HarrydeBug/WSPR-Receivers/Version4/README.md

# 1010-WSPR-RX_V2
Arduino firmware for WSPR-RX Hardware Version 4 with ESP82885 MCU
Harware version 4 is a Upper Sideband - Single Sideband recevier, the previous version were Double Sideband receivers.

LO Frequency and Crystal frequency is set with Serial commands and stored in EEPROM
The output frequency from the Si5351 is four times the LO frequency.
