HarrydeBug/WSPR-Receivers/Version4/Documentation/Ver4-rev 3 and 4 Audio Cable problem.pdf

### Important note on cable insertion on WSPR-RX Hardware Version 4.3 and 4.4

In version 4.3 and 4.4 of the WSPR receivers the audio out female does not protrude long enough to give a good connection unless the audio cable is pushed all the way in.
If the cable is not pushed all the way so the side of the audio cable is flush to side of the box there will be no sound out.
The difference in distance is just one millimeter.
See pictures below.

Casual insertion of the Audio cable looks like this.
No audio will get out.

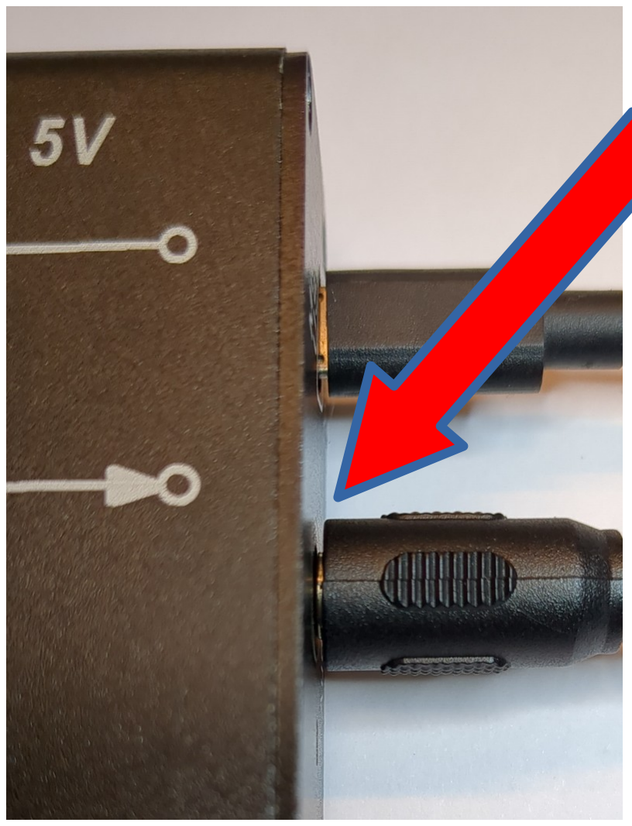
[picture p1: figure]
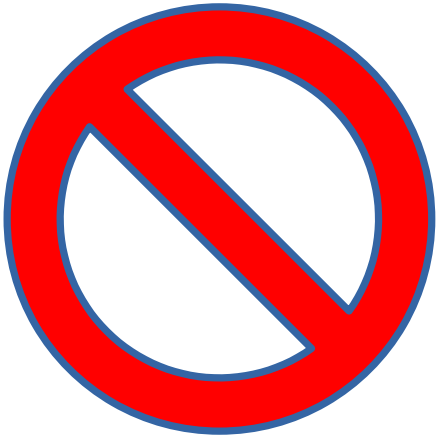
[picture p2: figure]

Pushing it all the way in makes all the difference and the audio will be sent to the cable.
Audio functions properly.

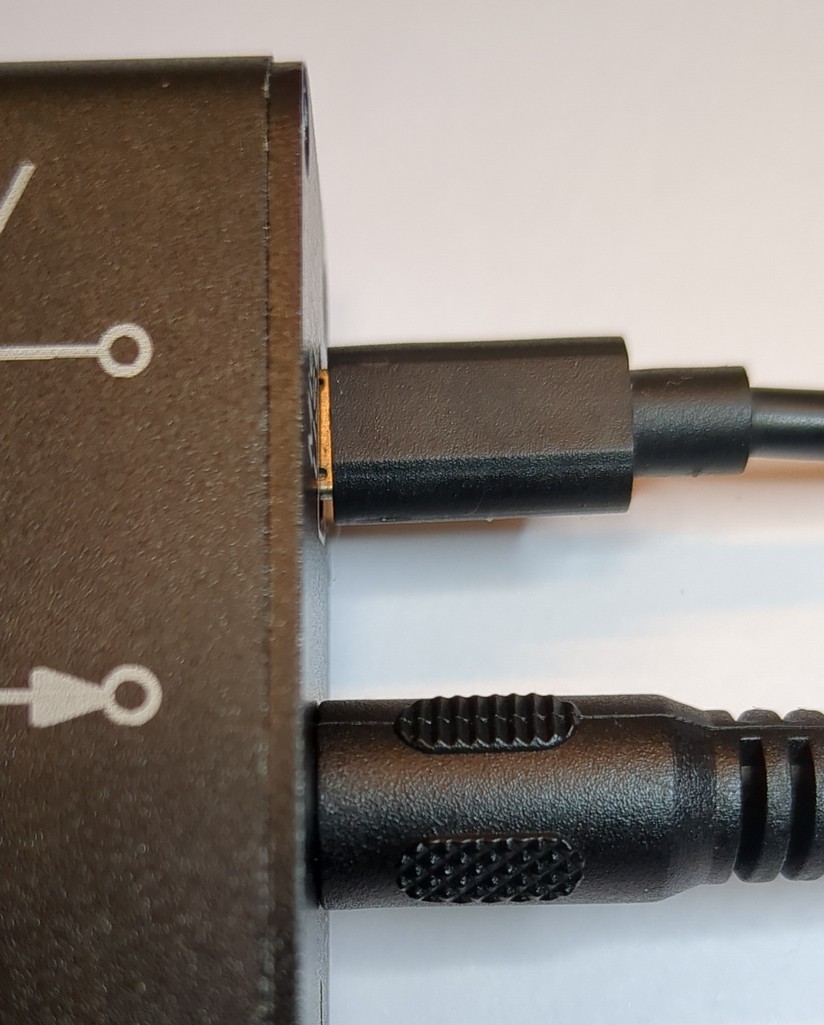
[picture p3: figure]
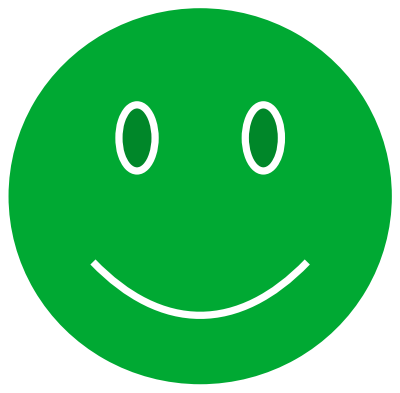
[picture p4: figure]
