HarrydeBug/WSPR-Receivers/1055/Documentation/Schema/Schemat_#1055-V1R6-WSPR-RX-Multi-band_2024-08-22.pdf

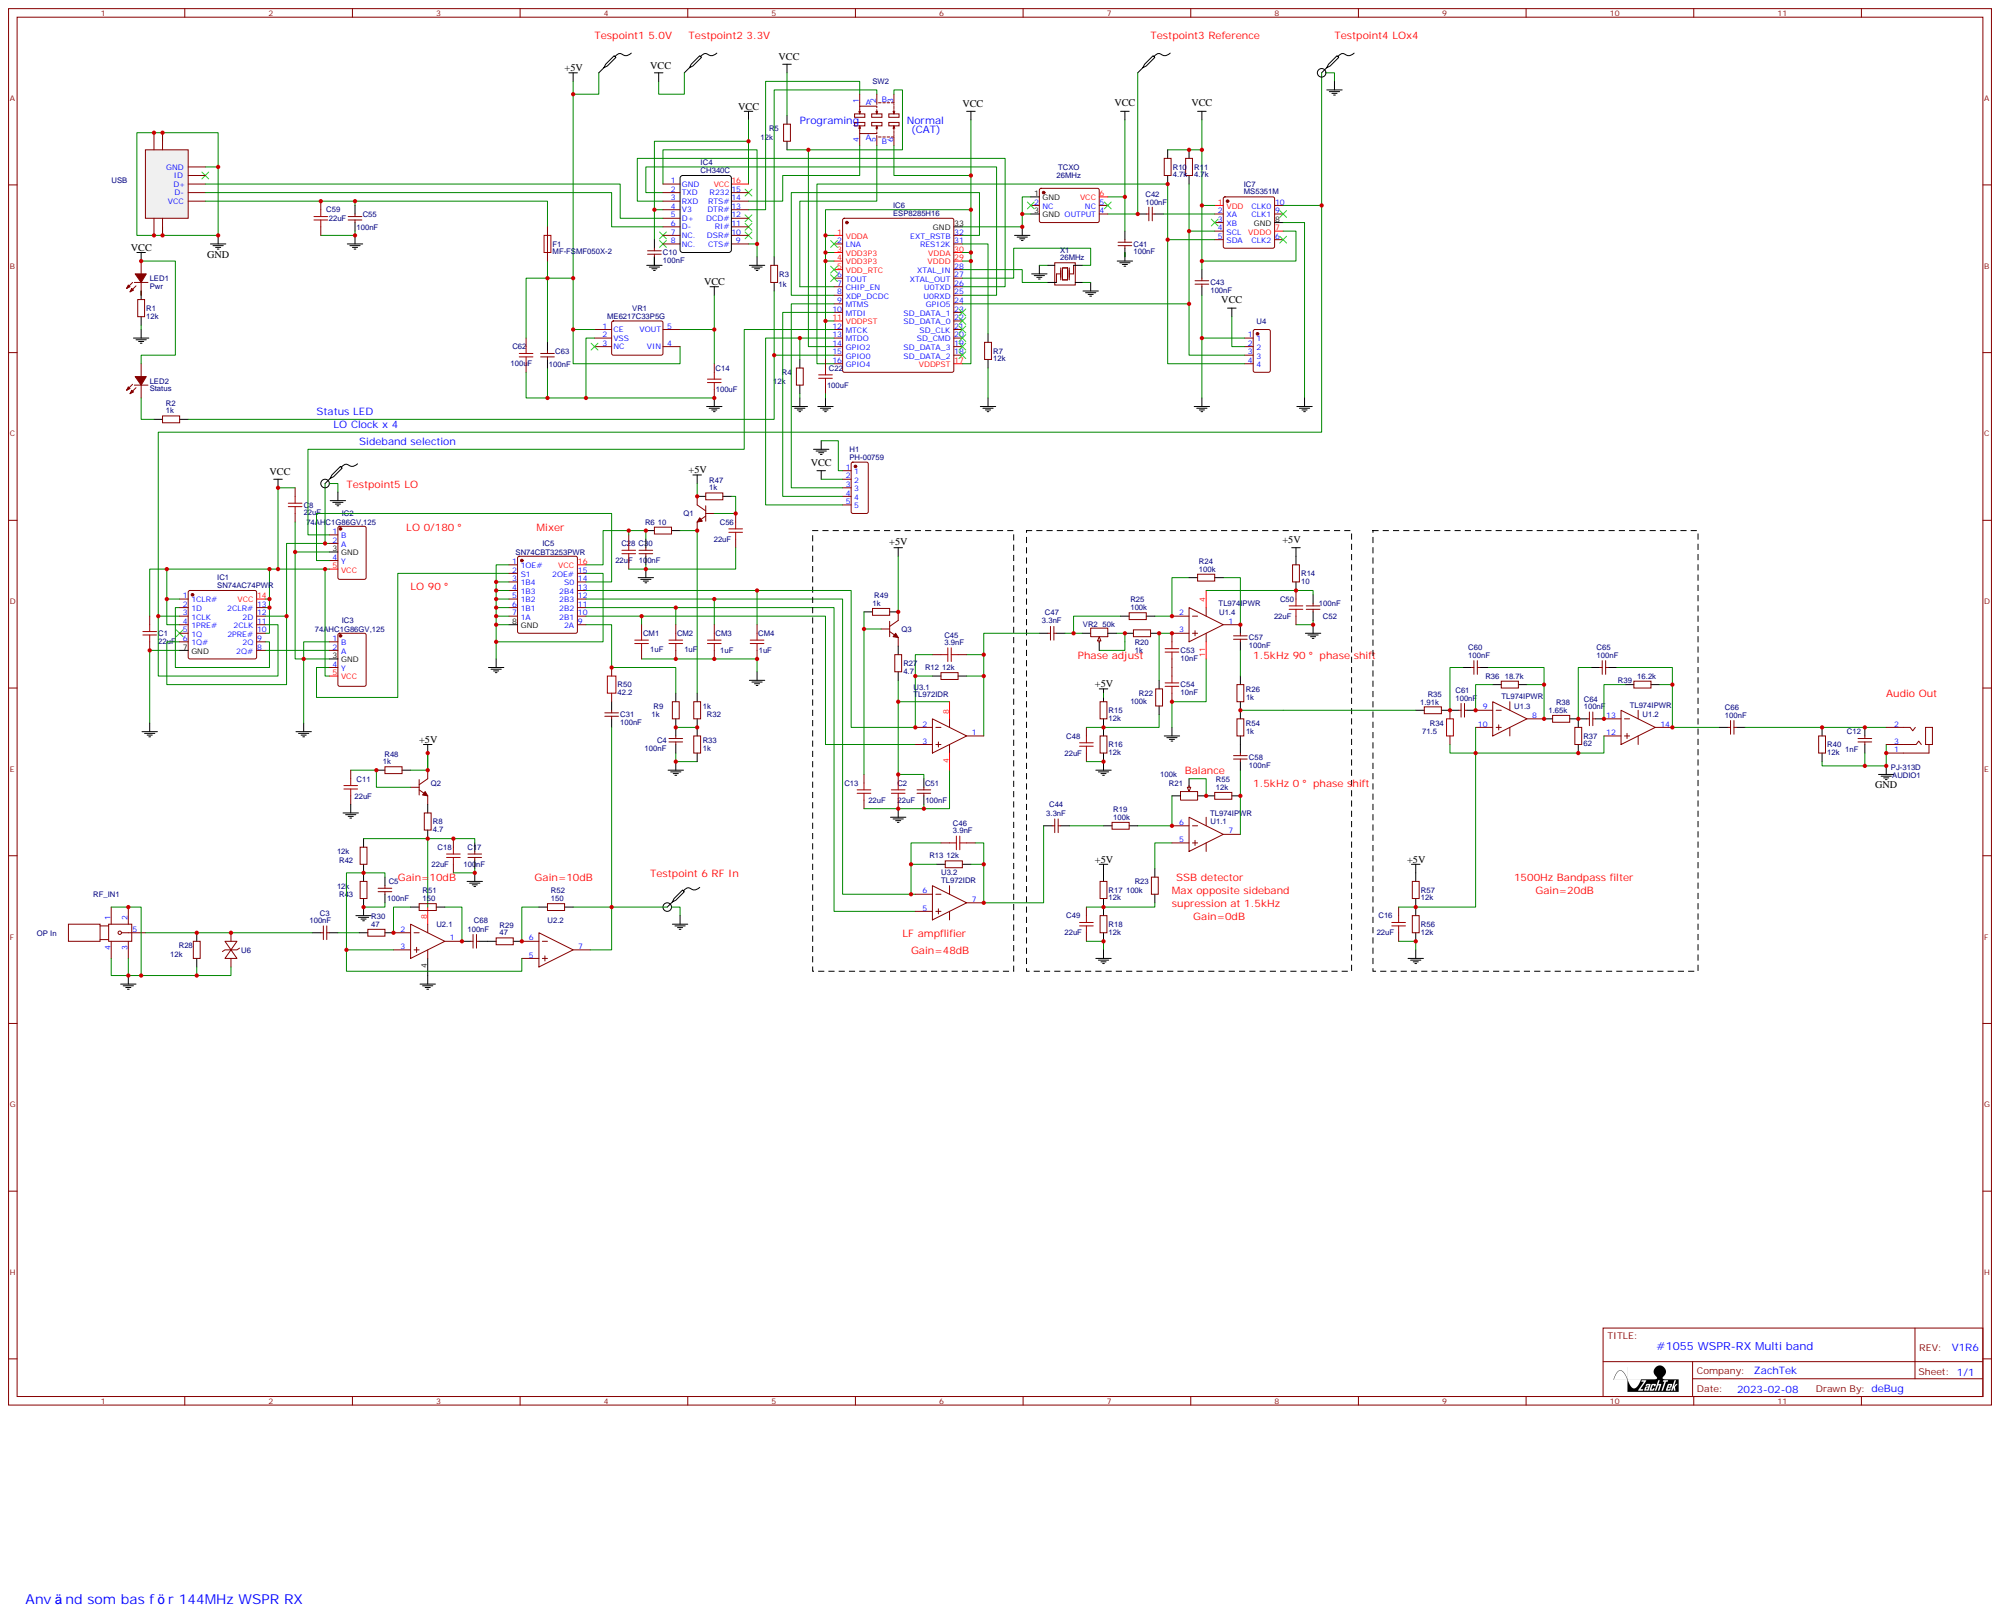
[picture p5: page 1]

GND 1

Anv nd som bas f r 144MHz WSPR RX
