HarrydeBug/WSPR-Receivers/Version3/Schema/WSPR-RX V3SchemaRX.pdf

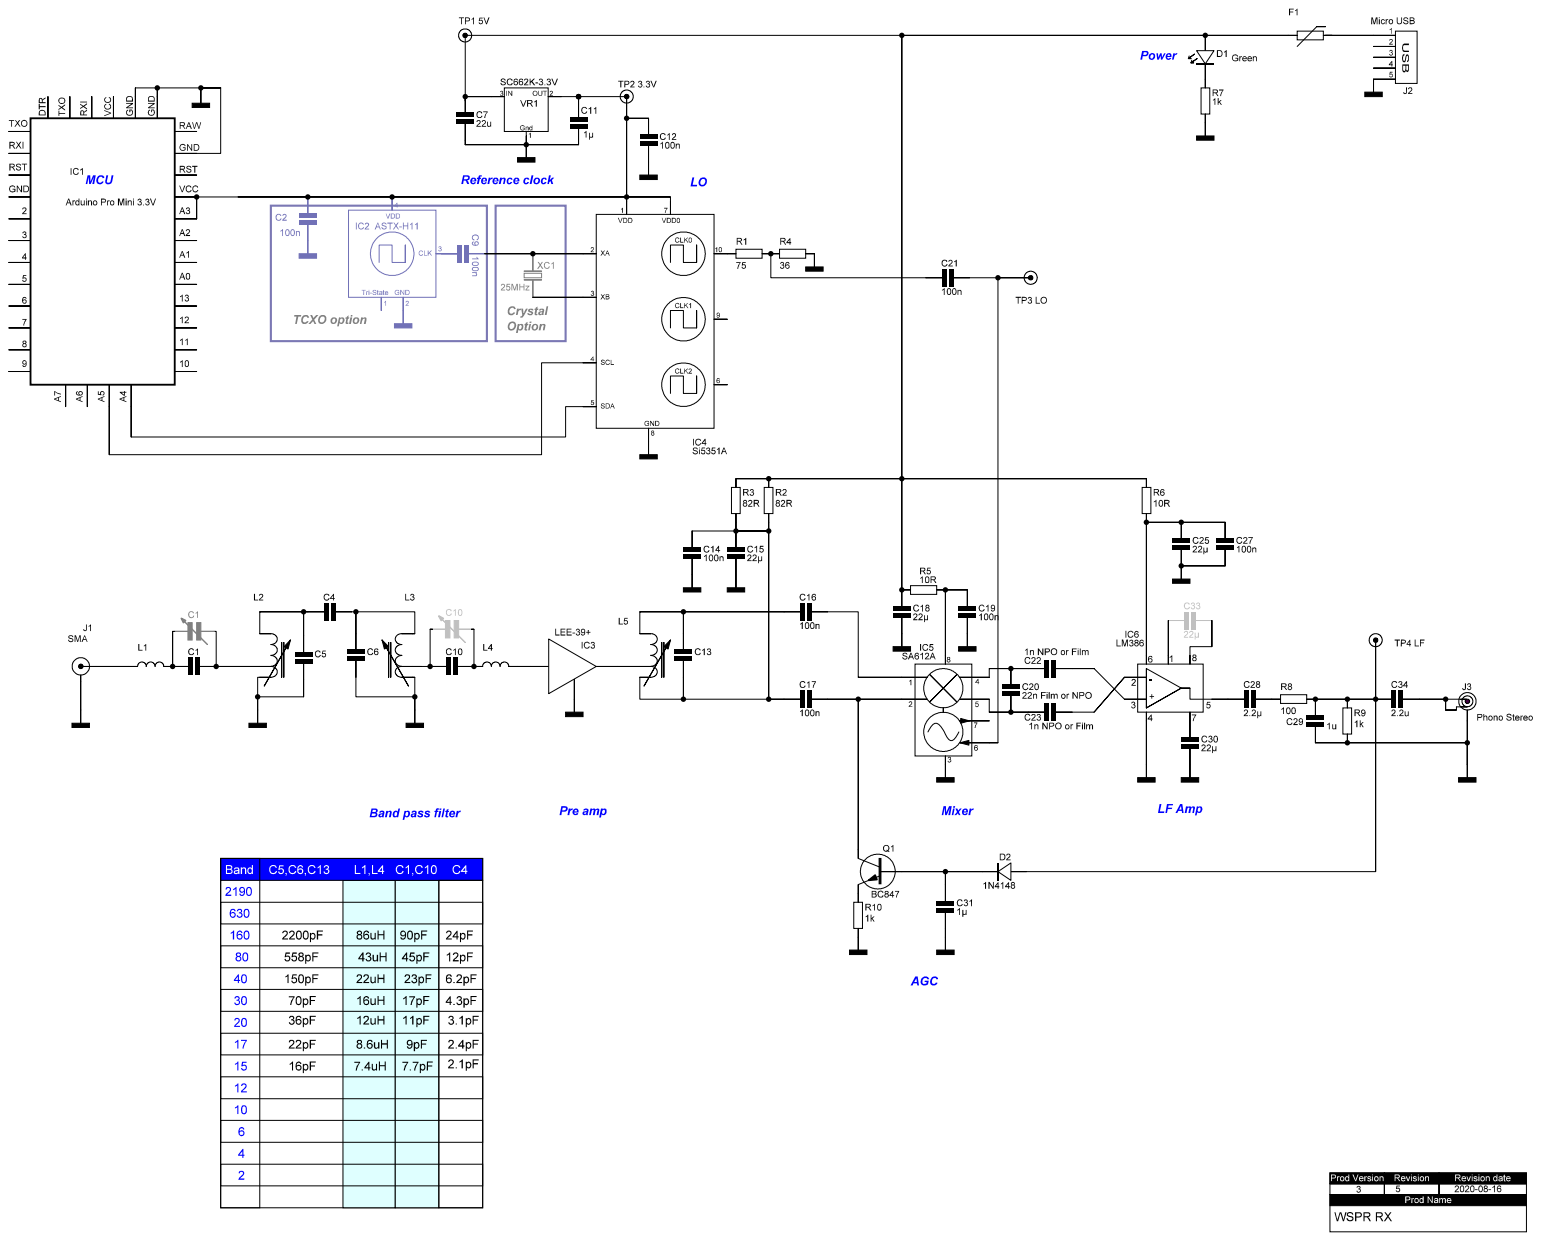
[picture p6: page 1]
