HarrydeBug/WSPR-Receivers/(notices)

Notices in the files:
1055/Firmware/1055_RX_Ver1_0/IC746.cpp:
This program is free software: you can redistribute it and/or modify
it under the terms of the GNU General Public License as published by
the Free Software Foundation, either version 3 of the License, or
(at your option) any later version.
